WeActStudio/WeActStudio.STM32F4_64Pin_CoreBoard/Hardware/WeAct-STM32F4_64PIN-CoreBoard_V11 SchDoc.pdf

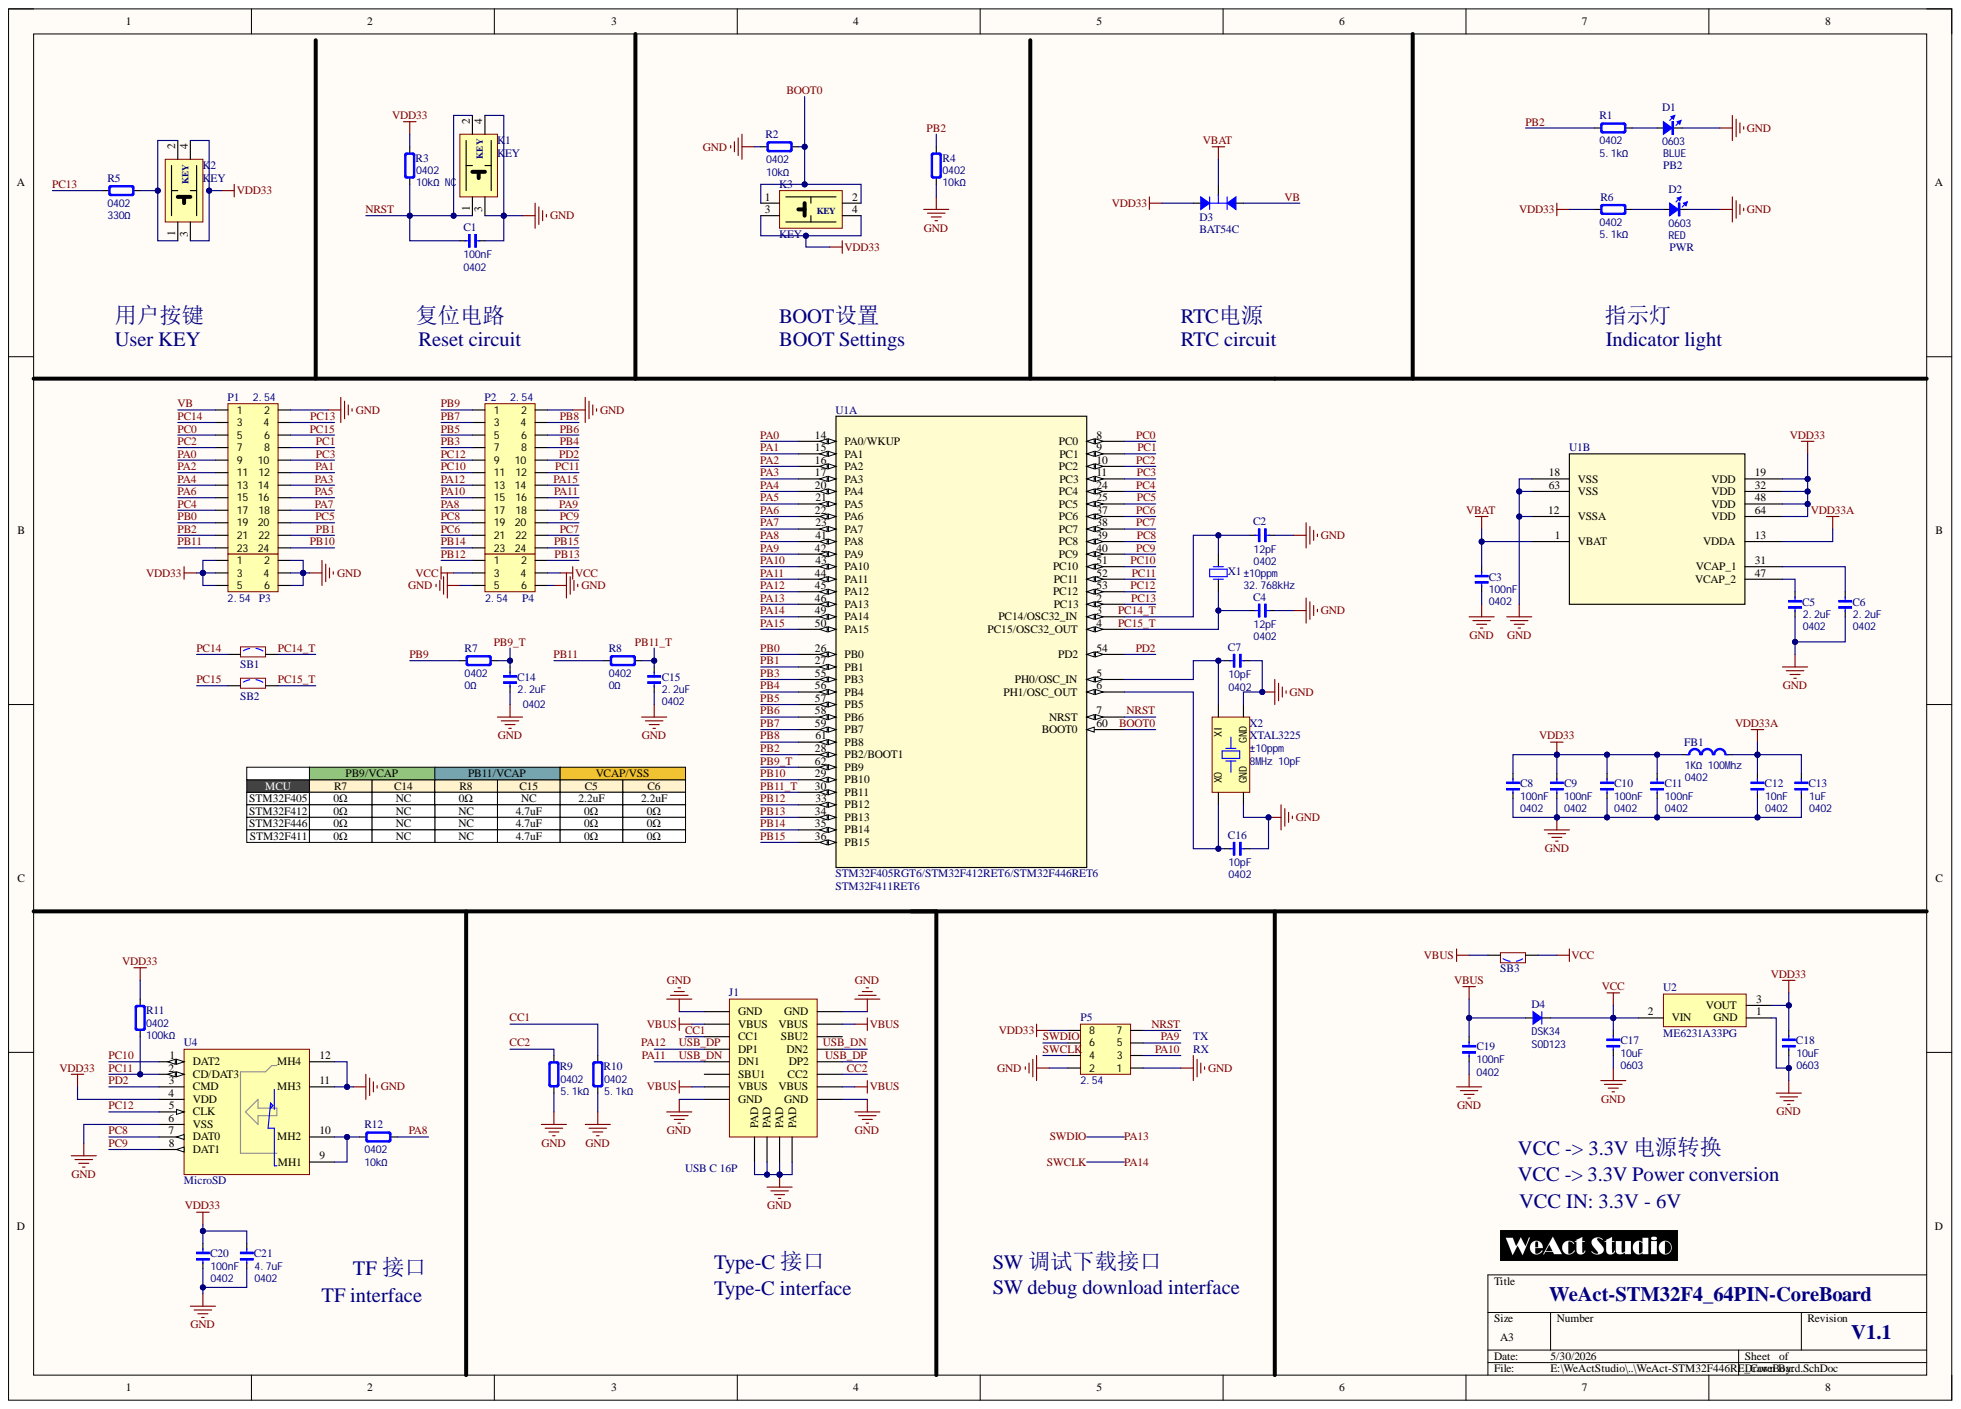
[picture p3: page 1]

MCU | R7 | C14 | R8 | C15 | C5 | C6 | PB11_T | PB11 30
STM32F405 | 0Ω | NC | 0Ω | NC | 2.2uF | 2.2uF | PB12 | PB12 33
STM32F412 | 0Ω | NC | NC | 4.7uF | 0Ω | 0Ω | PB13 | PB13 34
STM32F446 | 0Ω | NC | NC | 4.7uF | 0Ω | 0Ω | PB14 | PB14 35
STM32F411 | 0Ω | NC | NC | 4.7uF | 0Ω | 0Ω | PB15 | PB15 36

PB9/VCAP | PB11/VCAP | VCAP/VSS | PB10 | PB10 29
