WeActStudio/WeActStudio.STM32F4_64Pin_CoreBoard/Hardware/WeAct-STM32F4_64PIN-CoreBoard_V11 Board Shape 外形.pdf

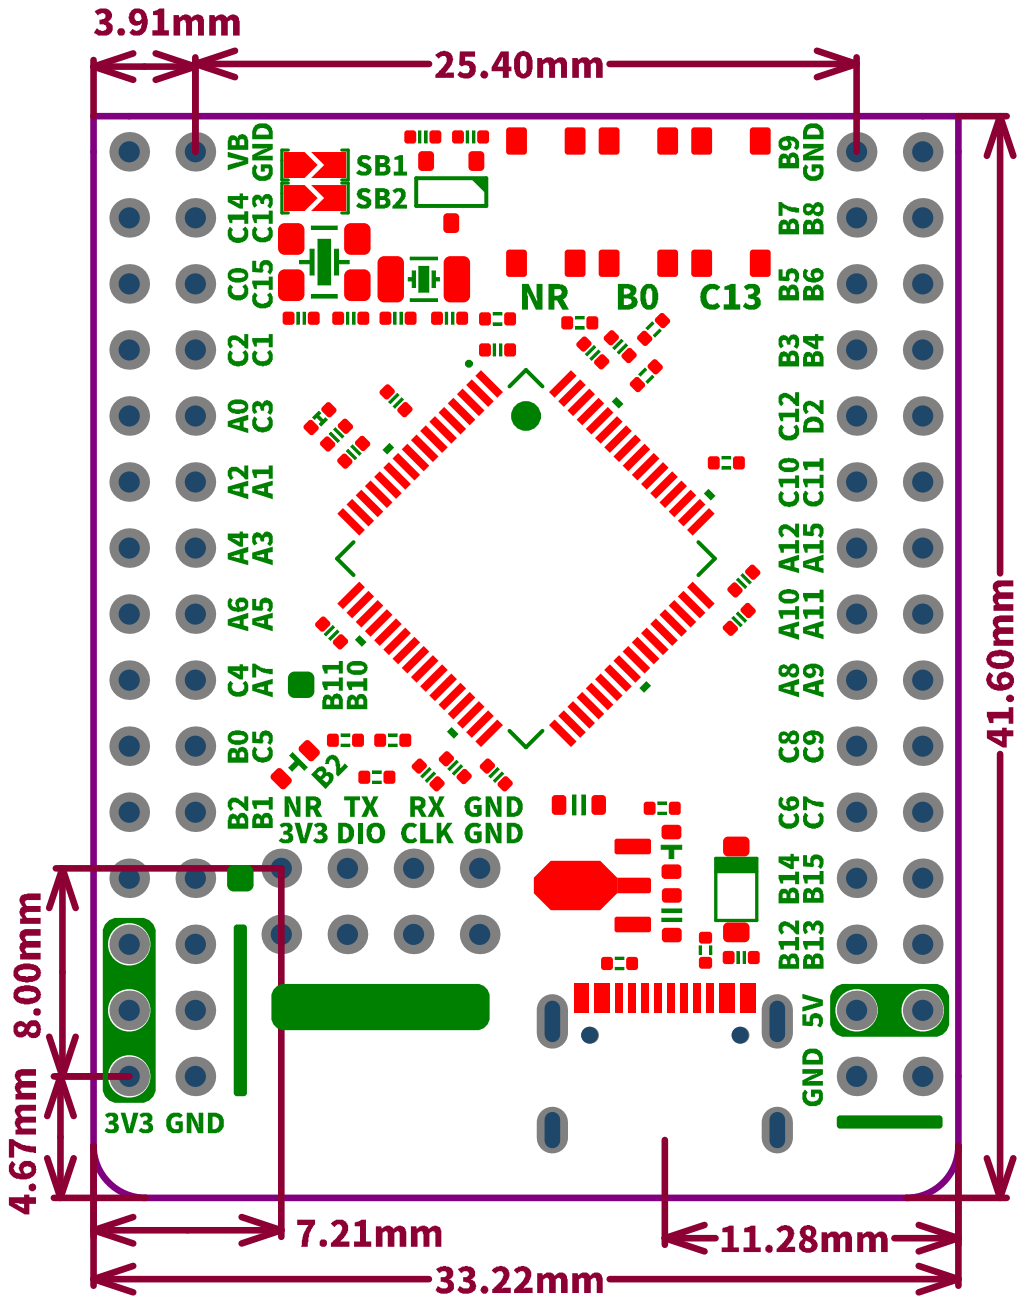
[picture p4: page 1]

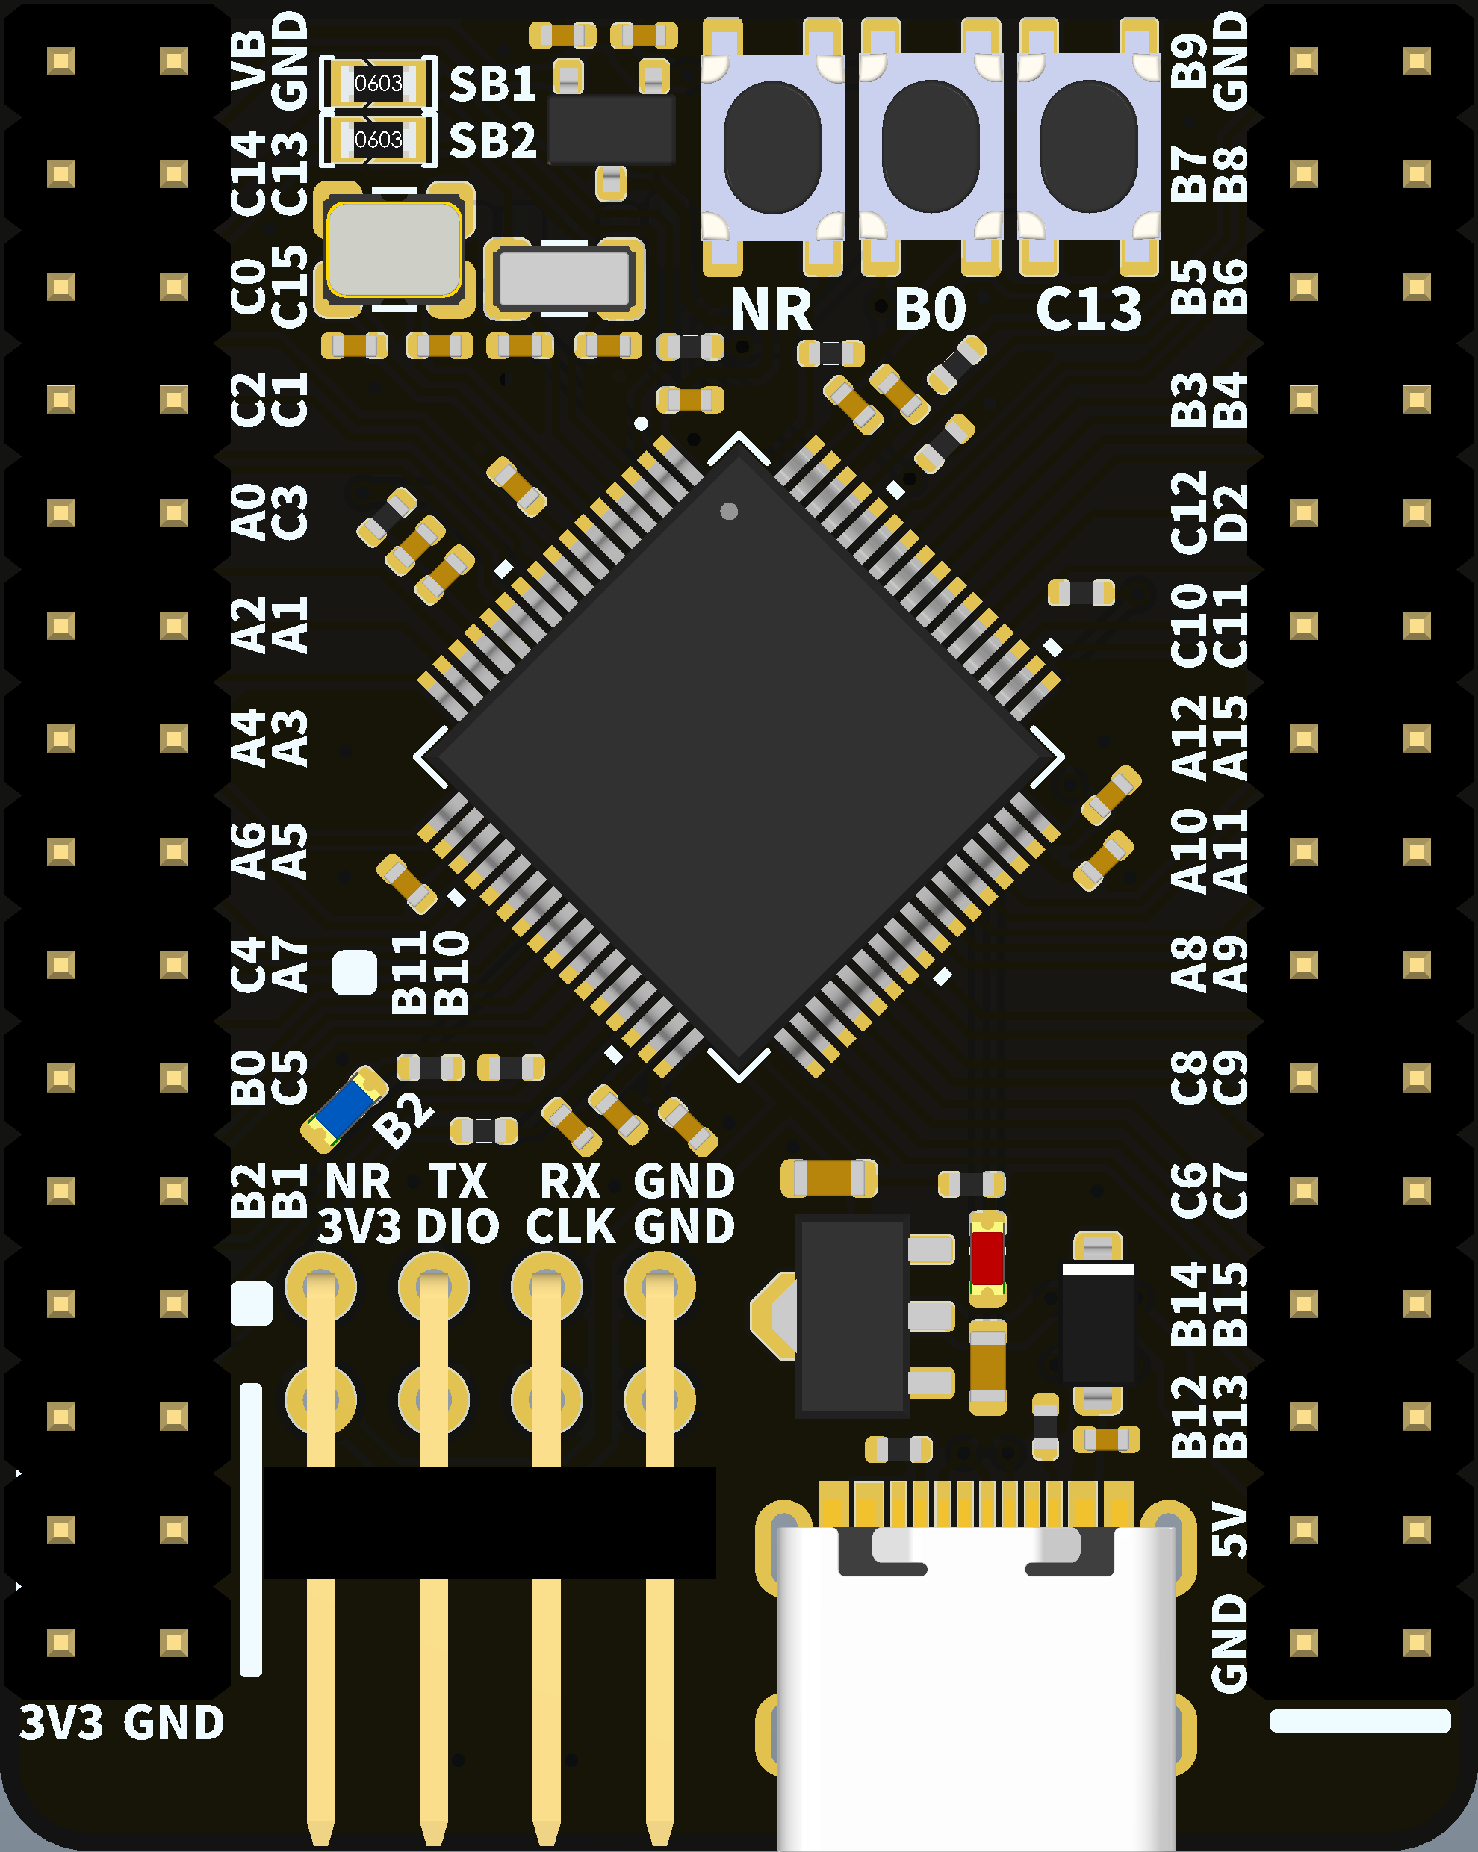
[picture p5: page 2]

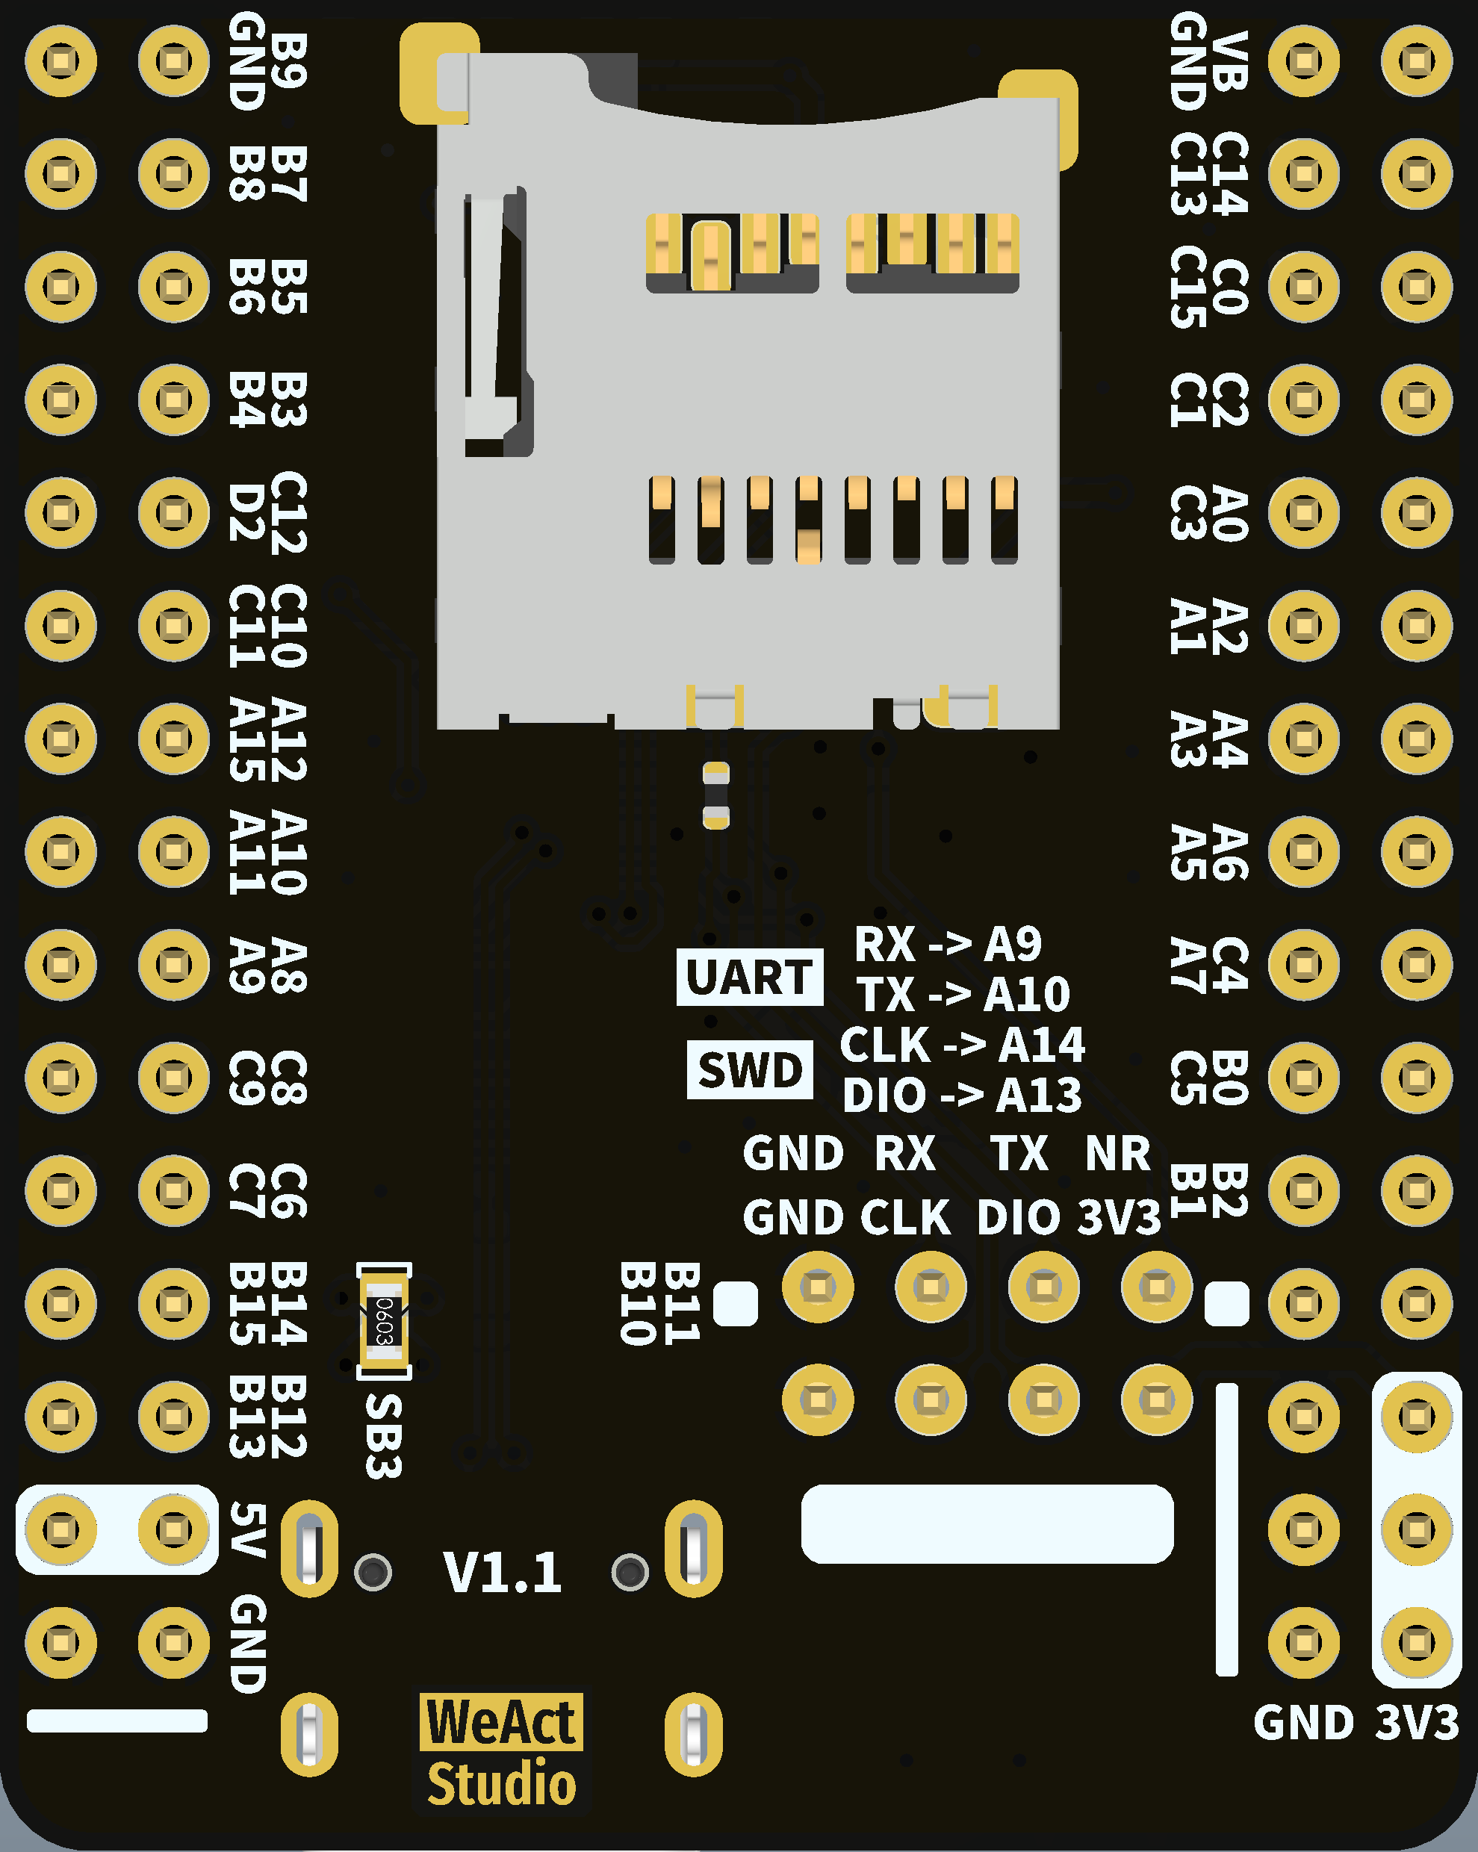
[picture p6: page 3]
