WeActStudio/WeActStudio.STM32F4_64Pin_CoreBoard/Hardware/WeAct-STM32F4_64PIN-CoreBoard_V10 Board Shape 外形.pdf

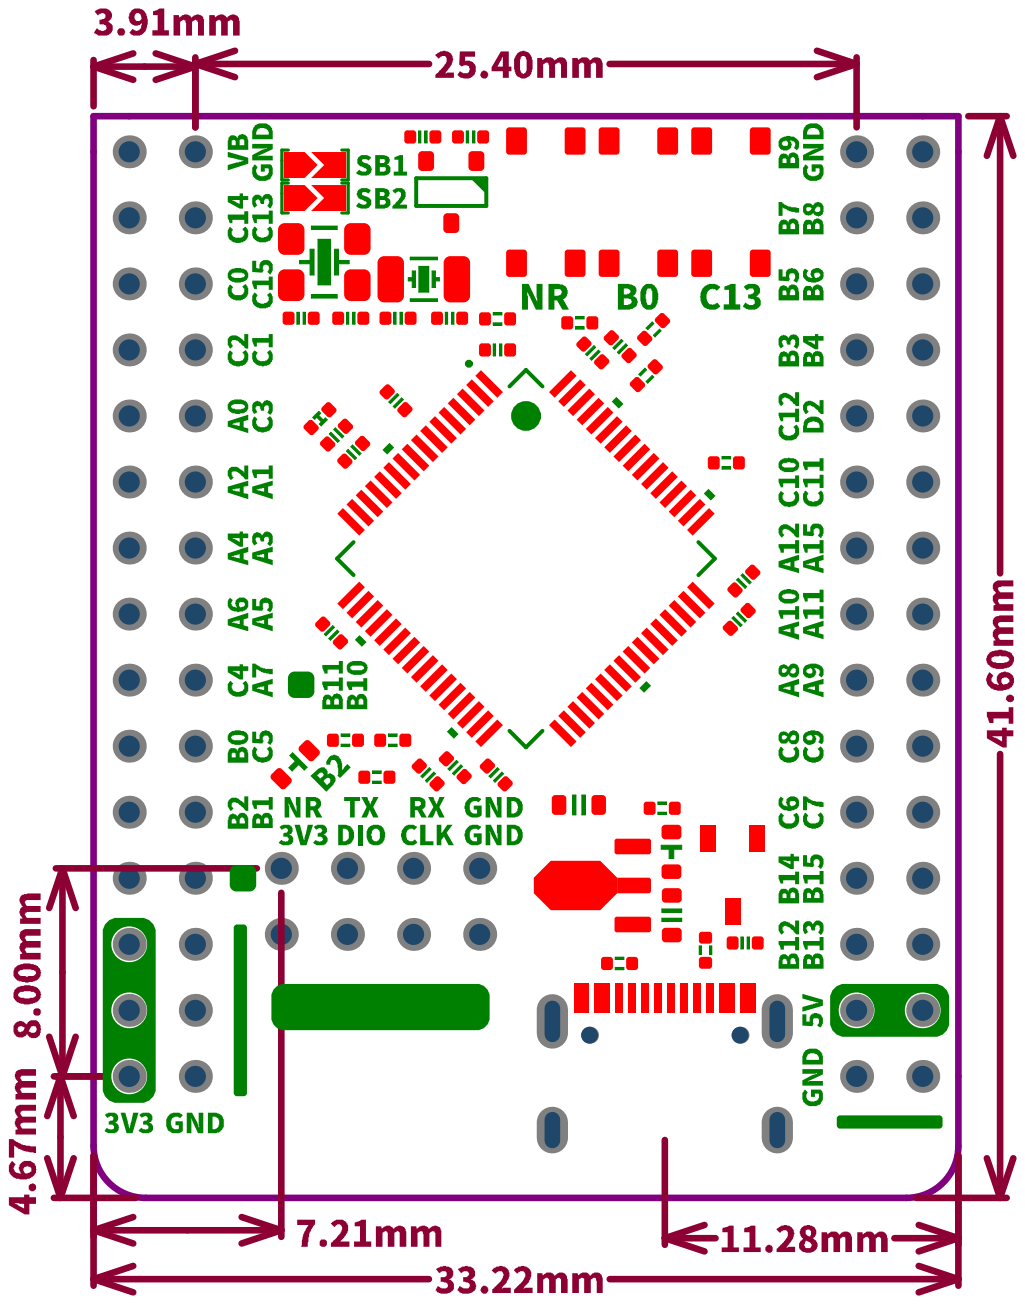
[picture p7: page 1]

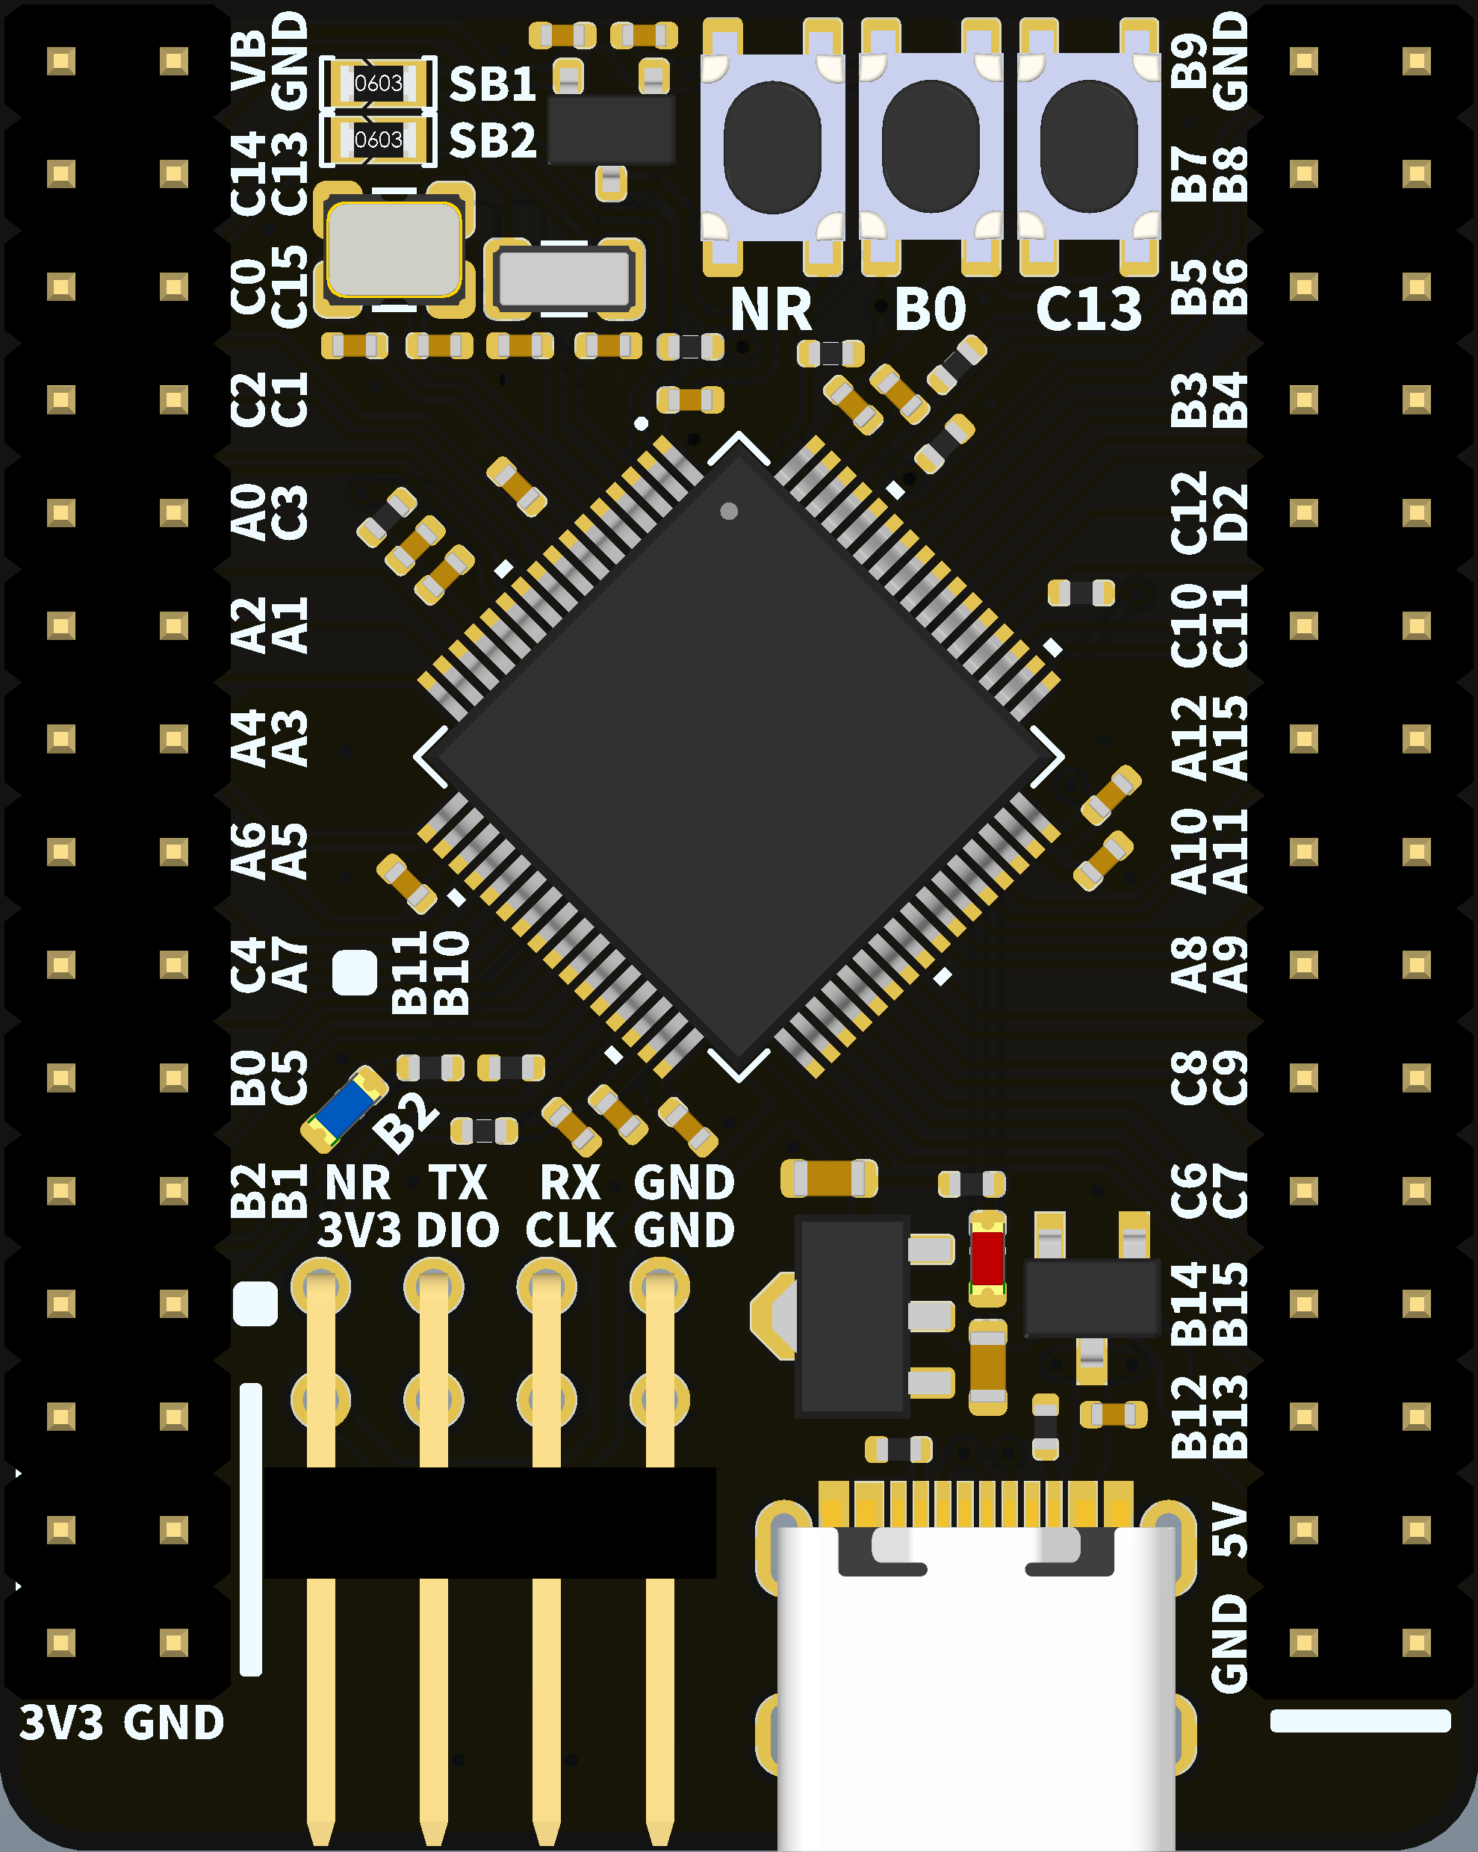
[picture p8: page 2]

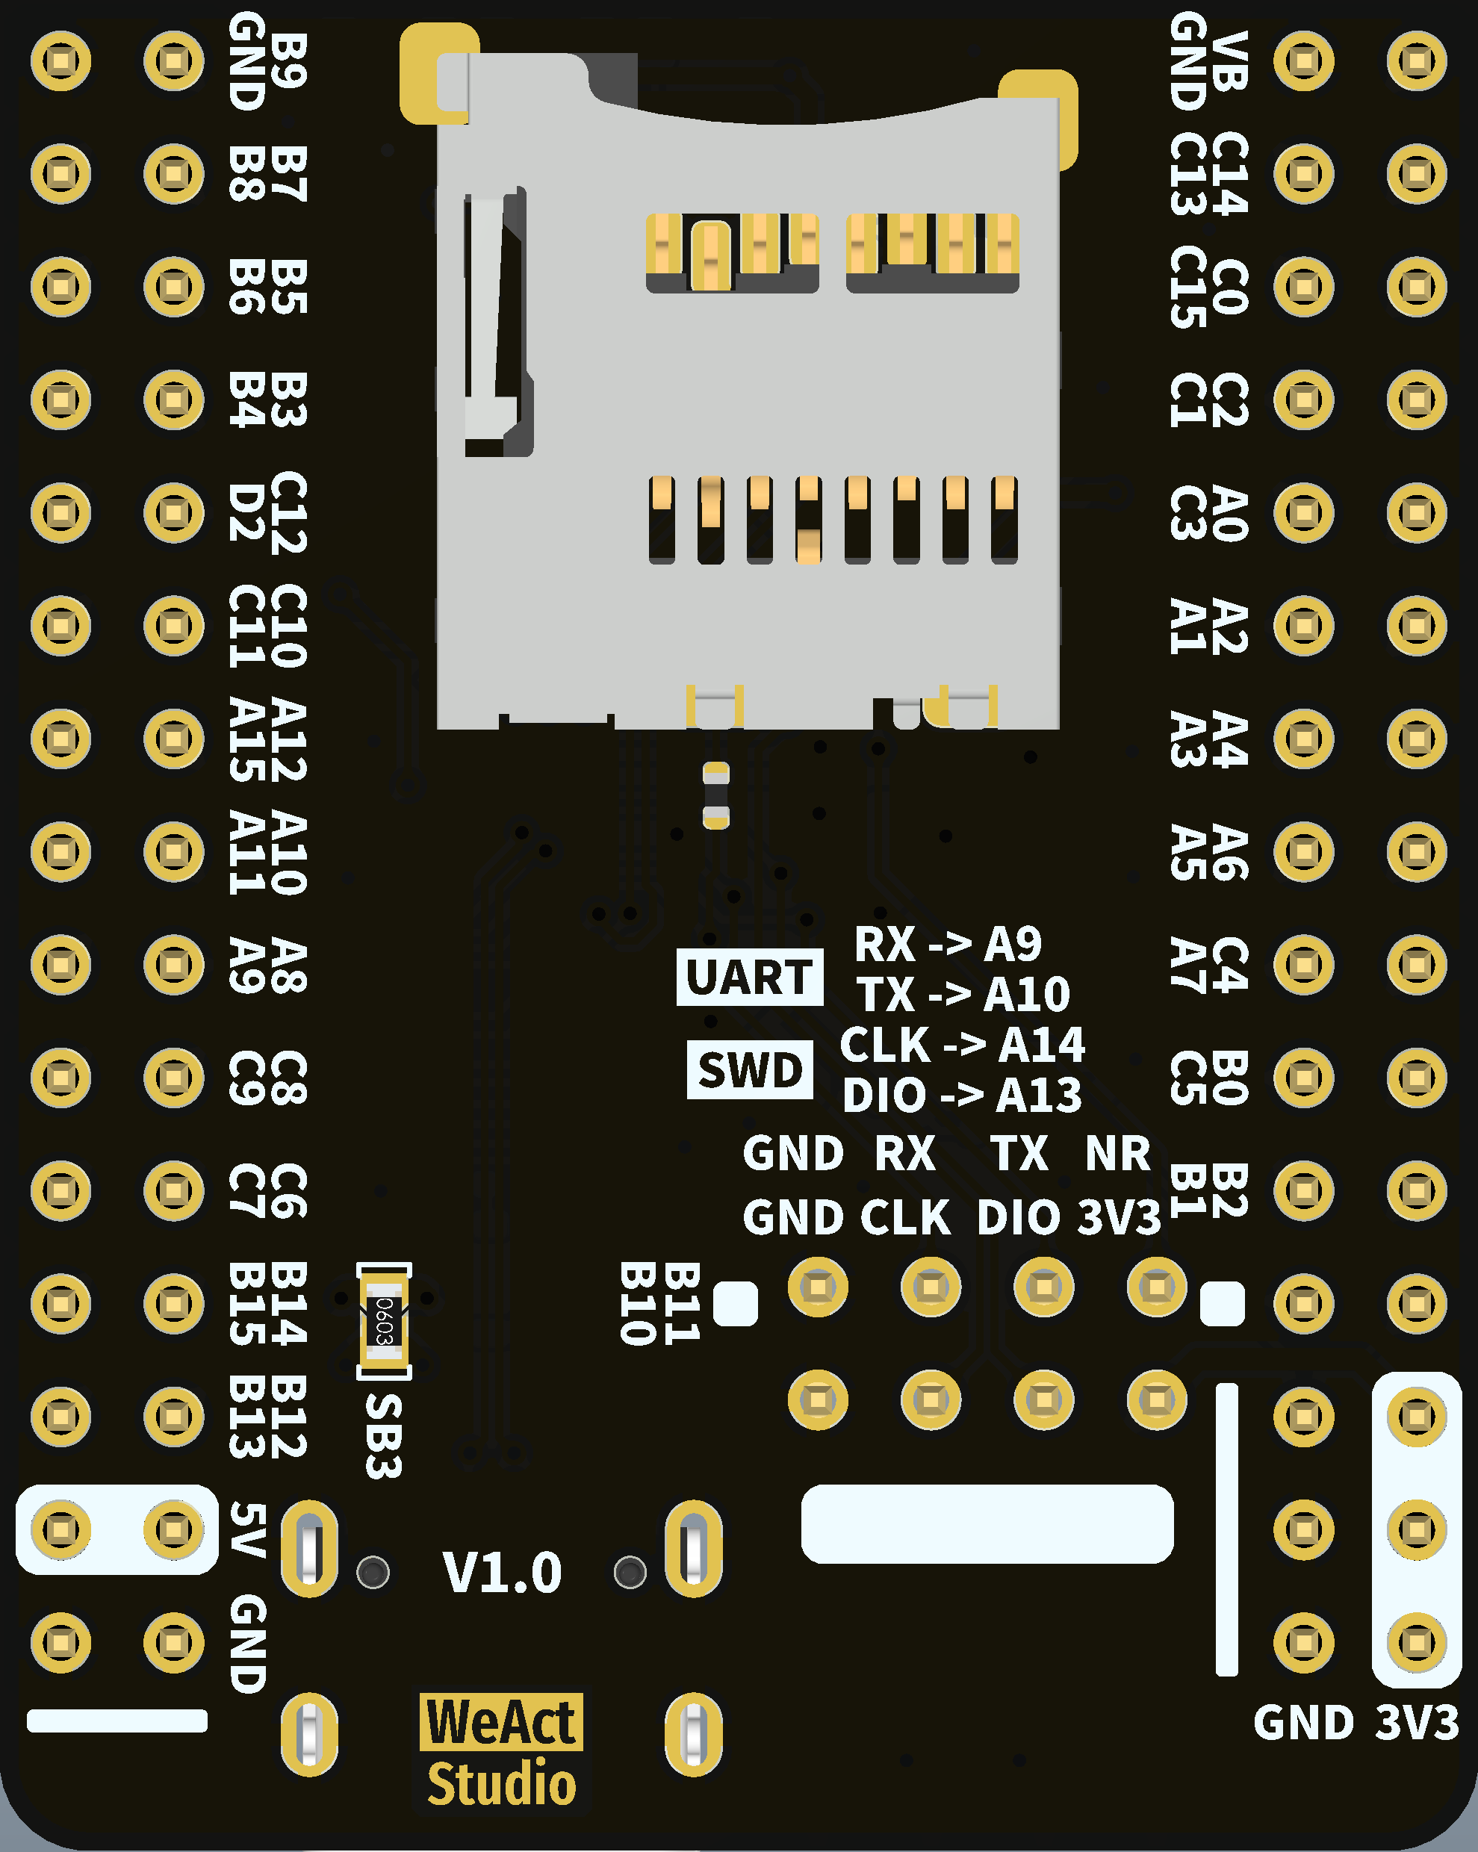
[picture p9: page 3]
