WeActStudio/WeActStudio.STM32F4_64Pin_CoreBoard/Examples/STM32F412/mpy/WeActStudio_F412RE/mpconfigboard.h

#define MICROPY_HW_BOARD_NAME       "WeActStudio_F412RE"
#define MICROPY_HW_MCU_NAME         "STM32F412RE"
#define MICROPY_HW_FLASH_FS_LABEL   "WeAct F412R"

#define MICROPY_HW_HAS_SWITCH       (1)
#define MICROPY_HW_HAS_FLASH        (1)
#define MICROPY_HW_ENABLE_RNG       (1)
#define MICROPY_HW_ENABLE_RTC       (1)
#define MICROPY_HW_ENABLE_USB       (1)
#define MICROPY_HW_ENABLE_SERVO     (1)
#define MICROPY_HW_ENABLE_SDCARD    (1)

// HSE is 8MHz, CPU freq set to 96MHz
#define MICROPY_HW_CLK_PLLM         (8)
#define MICROPY_HW_CLK_PLLN         (192)
#define MICROPY_HW_CLK_PLLP         (RCC_PLLP_DIV2)
#define MICROPY_HW_CLK_PLLQ         (4)

// The pyboard has a 32kHz crystal for the RTC
#define MICROPY_HW_RTC_USE_LSE      (1)
#define MICROPY_HW_RTC_USE_US       (0)
#define MICROPY_HW_RTC_USE_CALOUT   (1)

#define MICROPY_HW_UART1_TX         (pin_A9)
#define MICROPY_HW_UART1_RX         (pin_A10)
#define MICROPY_HW_UART2_TX         (pin_A2)
#define MICROPY_HW_UART2_RX         (pin_A3)
#define MICROPY_HW_UART6_TX         (pin_C6)
#define MICROPY_HW_UART6_RX         (pin_C7)
#define MICROPY_HW_UART_REPL        PYB_UART_1
#define MICROPY_HW_UART_REPL_BAUD   115200

// I2C buses
#define MICROPY_HW_I2C1_SCL         (pin_B8)
#define MICROPY_HW_I2C1_SDA         (pin_B9)
#define MICROPY_HW_I2C2_SCL         (pin_B10)
#define MICROPY_HW_I2C2_SDA         (pin_B3)

// SPI buses
#define MICROPY_HW_SPI1_NSS         (pin_A15) // shared with DAC
#define MICROPY_HW_SPI1_SCK         (pin_A5) // shared with DAC
#define MICROPY_HW_SPI1_MISO        (pin_A6)
#define MICROPY_HW_SPI1_MOSI        (pin_A7)

#define MICROPY_HW_SPI2_NSS         (pin_B12)
#define MICROPY_HW_SPI2_SCK         (pin_B13)
#define MICROPY_HW_SPI2_MISO        (pin_B14)
#define MICROPY_HW_SPI2_MOSI        (pin_B15)

#define MICROPY_HW_SPI3_NSS         (pin_A4)
#define MICROPY_HW_SPI3_SCK         (pin_B3)
#define MICROPY_HW_SPI3_MISO        (pin_B4)
#define MICROPY_HW_SPI3_MOSI        (pin_B5)

// CAN buses
#define MICROPY_HW_CAN1_TX          (pin_B9)
#define MICROPY_HW_CAN1_RX          (pin_B8)
#define MICROPY_HW_CAN2_TX          (pin_B6)
#define MICROPY_HW_CAN2_RX          (pin_B5)

// SD card detect switch
#define MICROPY_HW_SDCARD_DETECT_PIN        (pin_A8)
#define MICROPY_HW_SDCARD_DETECT_PULL       (GPIO_PULLUP)
#define MICROPY_HW_SDCARD_DETECT_PRESENT    (GPIO_PIN_SET)

// USRSW is pulled low. Pressing the button makes the input go high.
#define MICROPY_HW_USRSW_PIN        (pin_C13)
#define MICROPY_HW_USRSW_PULL       (GPIO_NOPULL)
#define MICROPY_HW_USRSW_EXTI_MODE  (GPIO_MODE_IT_RISING)
#define MICROPY_HW_USRSW_PRESSED    (1)

// LEDs
#define MICROPY_HW_LED1             (pin_B2) // Blue
#define MICROPY_HW_LED_ON(pin)      (mp_hal_pin_high(pin))
#define MICROPY_HW_LED_OFF(pin)     (mp_hal_pin_low(pin))

// USB config (CN13 - USB OTG FS)
#define MICROPY_HW_USB_FS           (1)
