WeActStudio/WeActStudio.STM32F4_64Pin_CoreBoard/Examples/STM32F411/HAL/01-RTC/Bsp/board.c

/*---------------------------------------
- WeAct Studio Official Link
- taobao: weactstudio.taobao.com
- aliexpress: weactstudio.aliexpress.com
- github: github.com/WeActStudio
- gitee: gitee.com/WeActStudio
- blog: blog.weactstudio.com
---------------------------------------*/

#include "board.h"

void board_button_init(void)
{
  GPIO_InitTypeDef GPIO_InitStruct = {0};
  
  /* GPIO Ports Clock Enable */
  KEY_GPIO_CLK_ENABLE();
  
  /*Configure GPIO pin : PtPin */
  GPIO_InitStruct.Pin = KEY_Pin;
  GPIO_InitStruct.Mode = GPIO_MODE_INPUT;
  GPIO_InitStruct.Pull = GPIO_PULLDOWN;
  HAL_GPIO_Init(KEY_GPIO_Port, &GPIO_InitStruct);
}

uint8_t board_button_getstate(void)
{
  return HAL_GPIO_ReadPin(KEY_GPIO_Port,KEY_Pin)==GPIO_PIN_SET?1:0;
}

void board_led_init(void)
{
  GPIO_InitTypeDef GPIO_InitStruct = {0};
  
  /* GPIO Ports Clock Enable */
  LED_GPIO_CLK_ENABLE();
  
  /*Configure GPIO pin Output Level */
  HAL_GPIO_WritePin(LED_GPIO_Port, LED_Pin, GPIO_PIN_RESET);
  
  /*Configure GPIO pin : PtPin */
  GPIO_InitStruct.Pin = LED_Pin;
  GPIO_InitStruct.Mode = GPIO_MODE_OUTPUT_PP;
  GPIO_InitStruct.Pull = GPIO_NOPULL;
  GPIO_InitStruct.Speed = GPIO_SPEED_FREQ_LOW;
  HAL_GPIO_Init(LED_GPIO_Port, &GPIO_InitStruct);
}

void board_led_toggle(void)
{
    HAL_GPIO_TogglePin(LED_GPIO_Port,LED_Pin);
}

void board_led_set(uint8_t set)
{
    if (set)
        HAL_GPIO_WritePin(LED_GPIO_Port,LED_Pin,GPIO_PIN_SET);
    else
        HAL_GPIO_WritePin(LED_GPIO_Port,LED_Pin,GPIO_PIN_RESET);
}

void board_sd_detect_init(void)
{
  GPIO_InitTypeDef GPIO_InitStruct = {0};
  
  /* GPIO Ports Clock Enable */
  SD_DETECT_GPIO_CLK_ENABLE();
  
  /*Configure GPIO pin : PtPin */
  GPIO_InitStruct.Pin = SD_DETECT_Pin;
  GPIO_InitStruct.Mode = GPIO_MODE_INPUT;
  GPIO_InitStruct.Pull = GPIO_PULLUP;
  HAL_GPIO_Init(SD_DETECT_GPIO_Port, &GPIO_InitStruct);
}

uint8_t board_sd_detect_getstate(void)
{
  return HAL_GPIO_ReadPin(SD_DETECT_GPIO_Port,SD_DETECT_Pin)==GPIO_PIN_SET?1:0;
}
