WeActStudio/WeActStudio.STM32F4_64Pin_CoreBoard/(commit log)

2024-04-13 update Board Shape file and add 3D file
2026-05-30 add stm32f411ret6 core board
2026-07-14 update stm32f405 example
