WeActStudio/WeActStudio.STM32F4_64Pin_CoreBoard/(notices)

Notices in the files:
Examples/STM32F405/HAL/01-RTC/Core/Src/main.c:
Copyright (c) 2023 STMicroelectronics.
All rights reserved.
This software is licensed under terms that can be found in the LICENSE file
